LongDouble/smart-chicken-coop/README.md

# smart-chicken-coop
Contains the files for the SmartCoop group 12 for Junior Design II Winter 2021 at Oregon State University.
