LongDouble/smart-chicken-coop/doc/fig/electrical-chars-2.pdf

Specifications | Adafruit MicroSD Card Breakout Board+ [ADA254] | Incandescent Heat Lamp | Nxtop Industrial Signal Light
Input Voltage | 5 VDC | 120 VAC | 12 VDC
Rated Voltage | 5 VDC | 120 VAC | 12 VDC
Current (nom) | 150 mA | 0 - 1.0 A | 170 mA
Current (max) | 150 mA | 1.0 A | 500 mA
Power | 750 mW (max) | 125 W | 2 W (max)
Operating Temperature | -45 C to 80 C | Unknown | Unknown
Other | SPI | Dimmable | N/A
