LongDouble/smart-chicken-coop/doc/fig/part-info-2.pdf

Heat Lamp Fixture | 1 | $ 10.98 | $ 10.98 | -
Heat Lamp Bulb | 1 | $ 7.97 | $ 7.97 | -
Outlet Cover | 1 | $ 8.21 | $ 8.21 | -
14-2 NM-B 25 ft (Romex Wire) | 1 | $ 11.52 | $ 11.52 | -
Plastic Junction Box | 1 | $ 1.15 | $ 1.15 | -
Wire Nuts (30 pac) | 1 | $ 2.78 | $ 2.78 | -
Grounded Outlet | 1 | $ 0.68 | $ 0.68 | -
PCB | 1 | $ 15.80 | $ 15.80 | Printed Circuit Board designed by team
120VAC Rocker Switch | 1 | $ 2.00 | $ 2.00 | IEC 320 C14 Male Plug Panel Mount Socket w/ Fuse and Switch
CONN RCPT MALE 3POS SOLDER CUP | 1 | $ 6.31 | $ 6.31 | Standard Circular Connector 3P PIN PANEL MNT
CONN PLUG FMALE 3POS SOLDER CUP | 1 | $ 12.97 | $ 12.97 | Standard Circular Connector 3P PIN PANEL MNT
CONN PLUG FMALE 4POS SOLDER CUP | 3 | $ 9.79 | $ 29.37 | Standard Circular Connector 4P SOCKET, SOLDER CABLE END
CONN RCPT MALE 4POS SOLDER CUP | 3 | $ 7.12 | $ 21.36 | Standard Circular Connector 4P SOCKET, SOLDER CABLE END
12V Power Supply | 1 | $ 8.56 | $ 8.56 | AC DC CONVERTER,15W, 12VDC
JST VH Connector Housing | 4 | $ 0.14 | $ 0.56 | CONN HOUSING VH 3POS 3.96MM WHT
Barrel Jack Cable | 1 | $ 4.04 | $ 4.04 | CABLE ASSY STR 2.1MM 6' 18 AWG
2.1mm x 5.5mm Jack | 1 | $ 1.00 | $ 1.00 | PJ-002A - CONN PWR JACK 2X5.5MM SOLDER
1x11 Female Header | 2 | $ 1.00 | $ 2.00 | 1X11 0.1" Female Header
1x4 Female Header | 9 | $ 0.33 | $ 3.00 | 1X4 0.1" Female Header
1x6 Female Header | 3 | $ 0.33 | $ 1.00 | 1X6 .1" Female Header
