LongDouble/smart-chicken-coop/doc/fig/part-info-3.pdf

Arduino Nano | 1 | $ 20.70 | 0 | Arduino Nano Board
22-18 AWG RED BUTT SPLICE | 1 | $ 5.98 | $ 5.98 | -
22-18 AWG SPADE TERMINALS | 1 | $ 3.33 | $ 3.33 | -
2A FUSE (2 pack) | 1 | $ 4.45 | $ 4.45 | -
Permatex 3oz Ultra Grey Silicone | 1 | $ 4.86 | $ 4.86 | -
Hex Bolt Zinc 5/16 x 2 in | 4 | $ 0.27 | $ 1.08 | -
1/2" X 7' Flexible Tubing | 1 | $ 5.49 | $ 5.49 | -
3/8" x 10' Flexible Tubing | 1 | $ 6.99 | $ 6.99 | -
Tupperware Container | 1 | $ 4.99 | $ 4.99 | -
6/12 Wood Screws (10 pack) | 1 | $ 1.59 | $ 1.59 | -
DS3231 RTC Breakout Board | 1 | $ 1.80 | $ 1.80 | DS3231 RTC Breakout Board R2
