LongDouble/smart-chicken-coop/doc/fig/pcb-mechanical.pdf

2.65

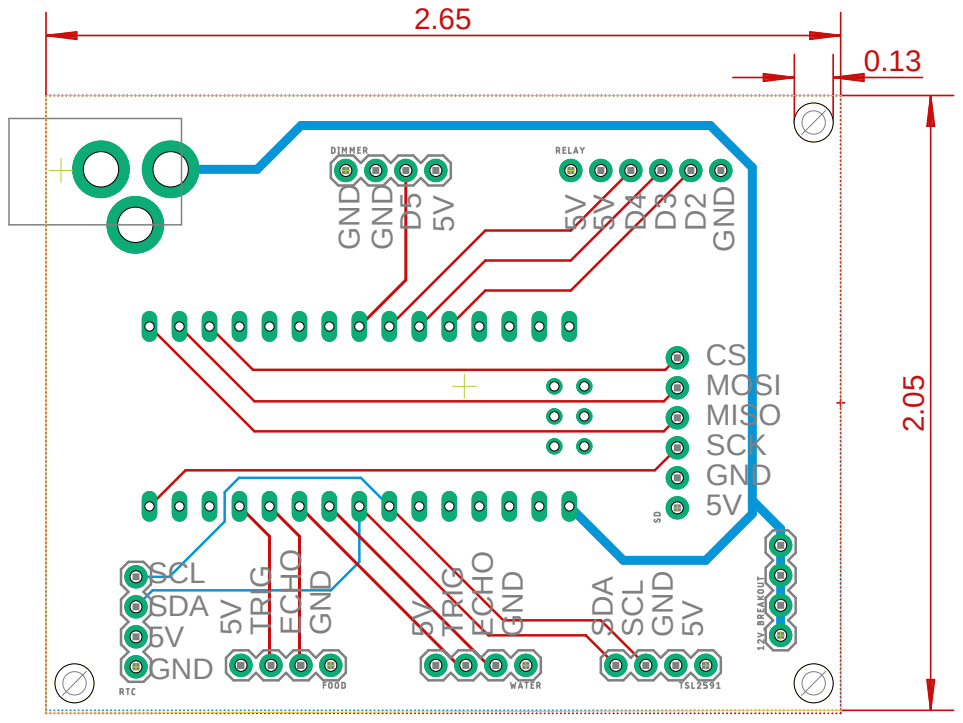
[picture p16: page 1]
0.13 5VTRIG ECHO GND; 5VTRIG ECHO GND; SDA SCL GND 5V GND GNDD⁵ 5V; 5V5VD⁴ D³ D² GND; GND; SCK; MISO; MOSI; SDA; SCL
