LongDouble/smart-chicken-coop/doc/fig/schematic.pdf

# Chicken Coop Monitoring System Schematic

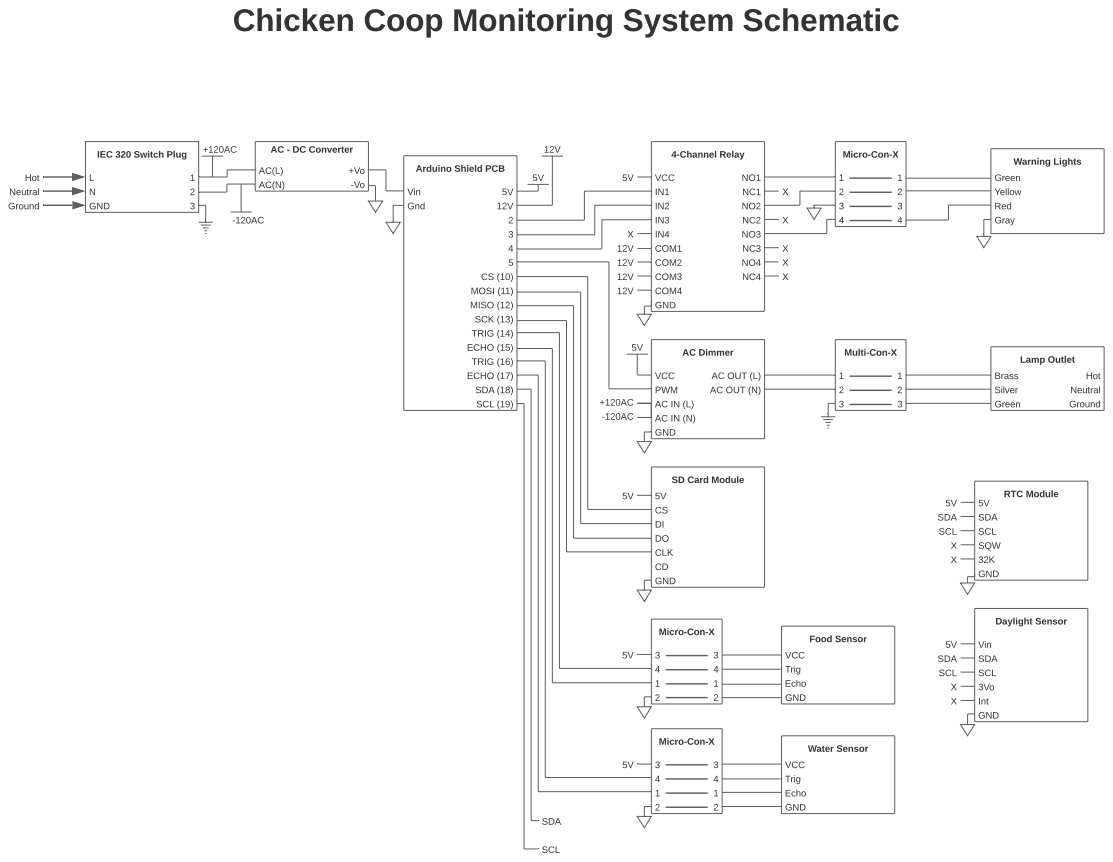
[picture p17: page 1]
GND; Micro-Con-X; Multi-Con-X; RTC Module; SDA SCL SQW 32K; 4-Channel Relay; VCC; IN1 IN2 IN3 IN4 COM1 COM2 COM3 COM4; Hot Neutral Ground; Daylight Sensor; Vin SDA SCL 3Vo Int GND; AC Dimmer; VCC PWM AC IN (L) AC IN (N) GND; AC OUT (L) AC OUT (N); SD Card Module; CLK; Vin Gnd; SDA (18) SCL (19); 2 3 4 5 CS (10) MOSI (11) MISO (12) SCK (13) TRIG (14) ECHO (15) TRIG (16) ECHO (17); SDA; SCL; 5V SDA SCL X X; Food Sensor; Trig Echo; Water Sensor; Lamp Outlet; Brass Silver Green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

IEC 320 Switch Plug

AC - DC Converter

Arduino Shield PCB
