LongDouble/smart-chicken-coop/doc/fig/block-diagram.pdf

# Chicken Coop Monitoring System Block Diagram

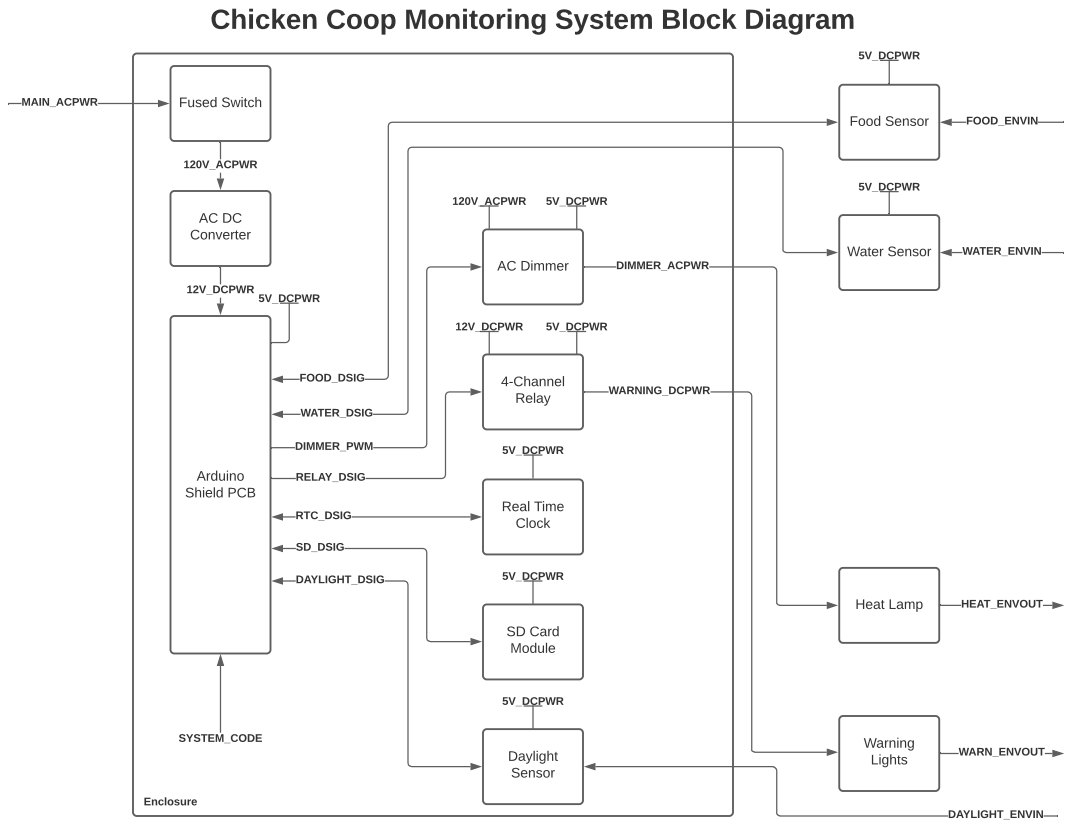
[picture p18: page 1]
Fused Switch; AC DC Converter; Real Time Clock; 5V_DCPWR; SD Card Module; MAIN_ACPWR; 120V_ACPWR; Arduino Shield PCB; 12V_DCPWR; 4-Channel Relay; Daylight Sensor; Heat Lamp; Warning Lights; DIMMER_ACPWR; WARNING_DCPWR; AC Dimmer; FOOD_DSIG; WATER_DSIG; DIMMER_PWM; RELAY_DSIG; RTC_DSIG; SD_DSIG; DAYLIGHT_DSIG; FOOD_ENVIN; WATER_ENVIN; HEAT_ENVOUT; WARN_ENVOUT; Food Sensor; Water Sensor; Enclosure; DAYLIGHT_ENVIN; SYSTEM_CODE
