LongDouble/smart-chicken-coop/(commit log)

2021-02-28 Added libraries for all sensors
2021-02-28 Warning lights and heat lamp at startup
2021-03-04 Commented Arduino and MATLAB script
2021-03-04 Added comments to heat lamp and warning lights
2021-03-05 Finished PCB Information
